physicsexpert/Multi-function-welding-filter-fan/(list of files, drawings)

Other design files:
hardware/自制焊接风扇.epro
